vlncn/Monitoring-and-Reporting-Driver-Character-Behaviours/docs/demo/Case from Up.jpg

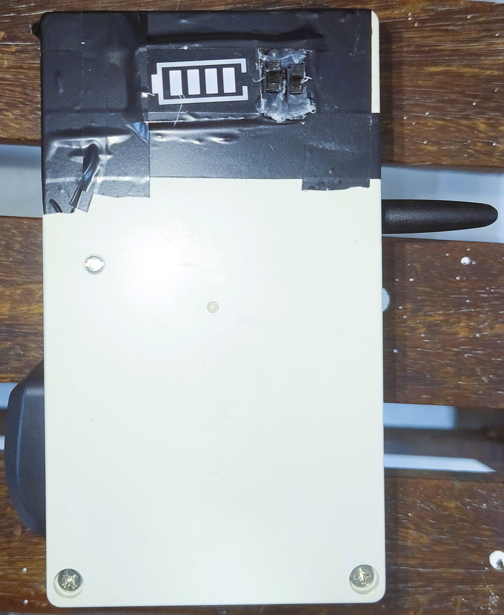
docs/demo/Case from Up.jpg
