vlncn/Monitoring-and-Reporting-Driver-Character-Behaviours/docs/demo/Case.jpg

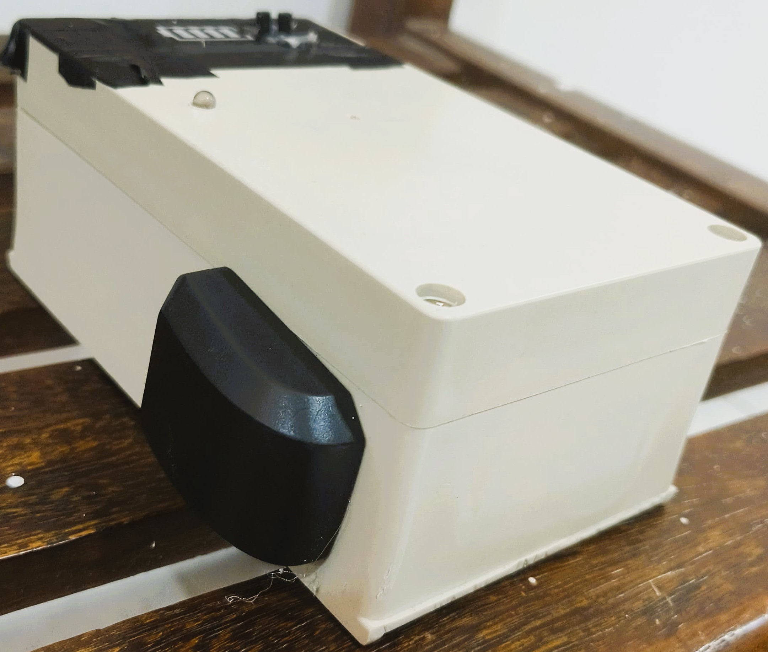
docs/demo/Case.jpg
