vlncn/Monitoring-and-Reporting-Driver-Character-Behaviours/README.md

# Monitoring-and-Reporting-Driver-Character-Behaviours
This is an archive for my capstone design. Built in 2024
