vlncn/Monitoring-and-Reporting-Driver-Character-Behaviours/docs/Architecture.png

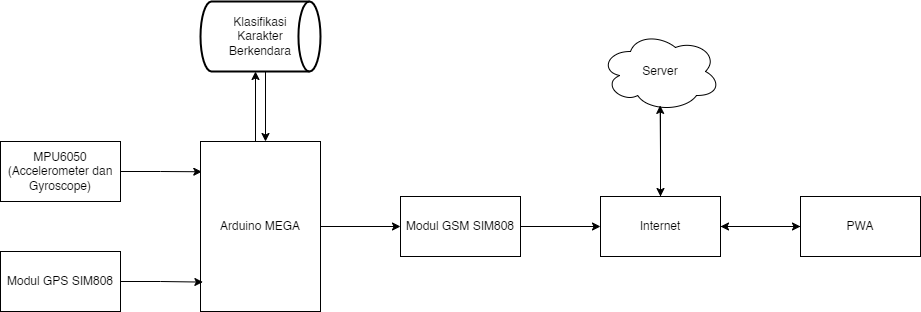
docs/Architecture.png
