vlncn/Monitoring-and-Reporting-Driver-Character-Behaviours/docs/demo/Dashboard.jpg

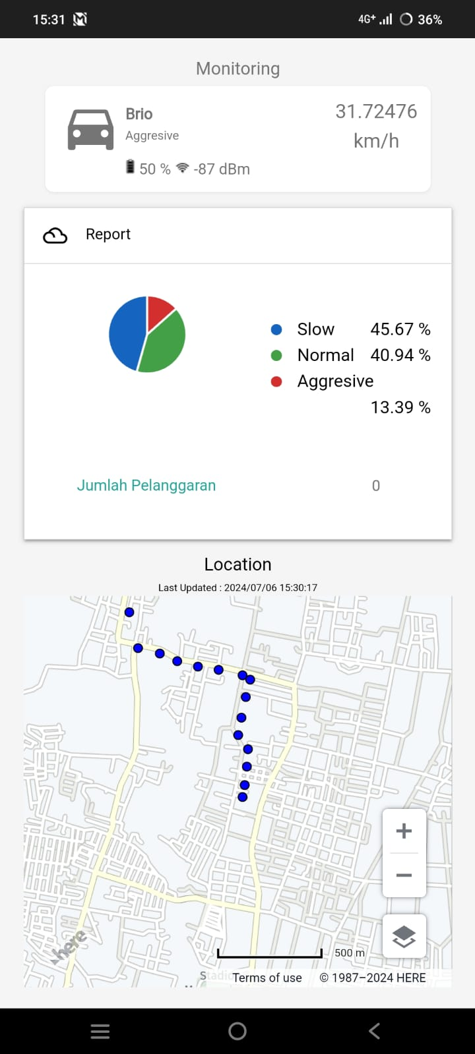
docs/demo/Dashboard.jpg
