vlncn/Monitoring-and-Reporting-Driver-Character-Behaviours/docs/demo/Start Screen.jpg

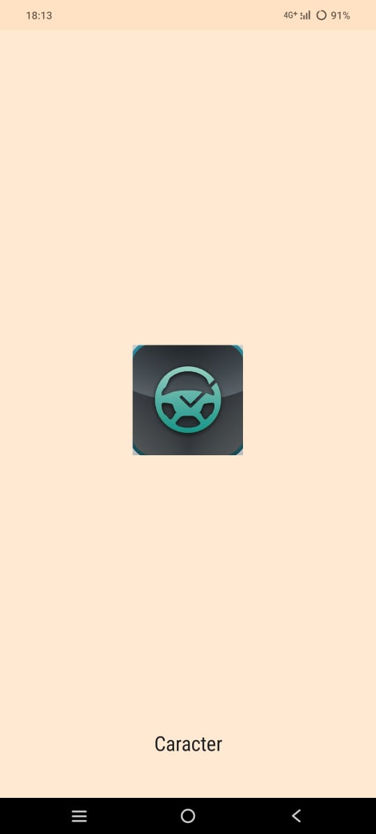
docs/demo/Start Screen.jpg
